Youngermaster/Irrigation-System/InformeFinalElectronica.docx

ELECTRÓNICA DIGITAL

PROYECTO FINAL

ESTUDIANTES:

Camila Barona Cabrera

María Antonia Rincón Zuluaga

Valeria Suárez Mejía

María Sofía Uribe Cano

Juan Manuel Young Hoyos

FECHA:

28 DE MAYO DE 2019

UNIVERSIDAD EAFIT

MEDELLÍN

2019

TABLA DE CONTENIDO

1. Descripción de la Aplicación IoT 2

2. Arquitectura del Sistema 2

3. Cálculos Electrónicos 2

4. Planos del Sistema 1

5. Código de Arduino 2

6. Presentación del Proyecto (Video) 2

7. Conclusiones 2

# 1. Descripción de la Aplicación IoT

Ubidots nos permite almacenar datos de sensores en la nube, además de que los podemos visualizar en tiempo real en la interfaz que nos ofrece Ubidots o en una página web.

En la imagen se puede ver como se almacenan todos los datos de los sensores que tenemos registrados.

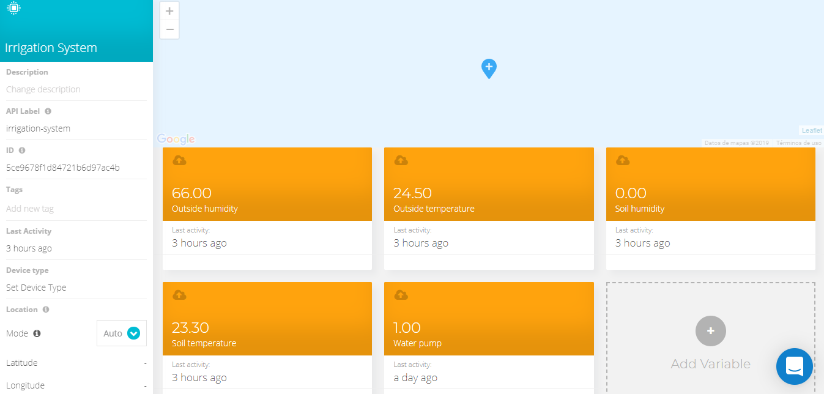
[picture p3: figure]

Podemos ver la gráfica de la actividad de cada variable.

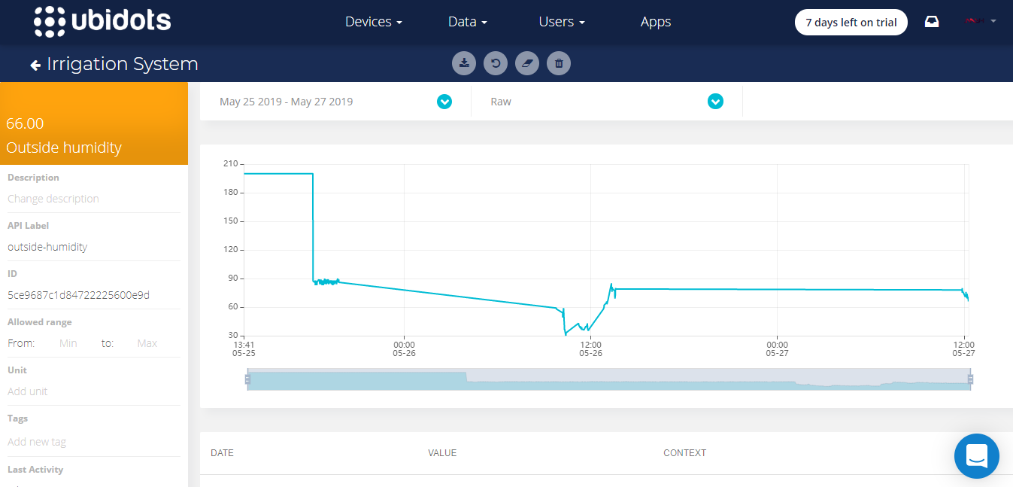
[picture p4: figure]

Y también vemos el reporte no gráfico del cambio de la variable con sus fechas y horas correspondientes.

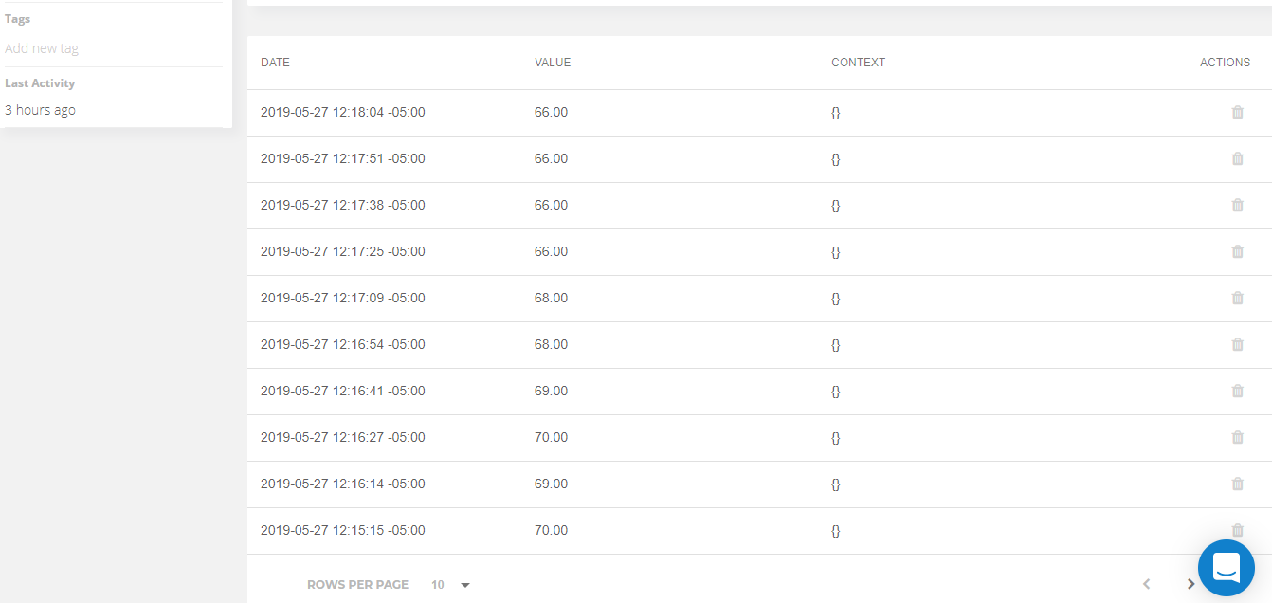
[picture p5: figure]

El usuario puede activar el riego de la planta manualmente, utilizando el botón que se encuentra en la página web, permitiendo así una interacción directa con el sistema.

El botón está relacionado con una variable booleana de Ubidots, que cambia el estado (encendido o apagado) de la variable que corresponde a la bomba de agua.

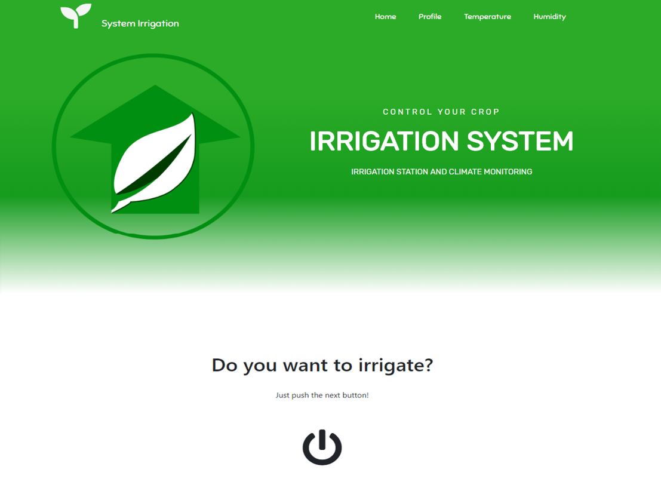
[picture p6: figure]

También en la página web se pueden ver los datos de las variables, que van a estar actualizándose constantemente.

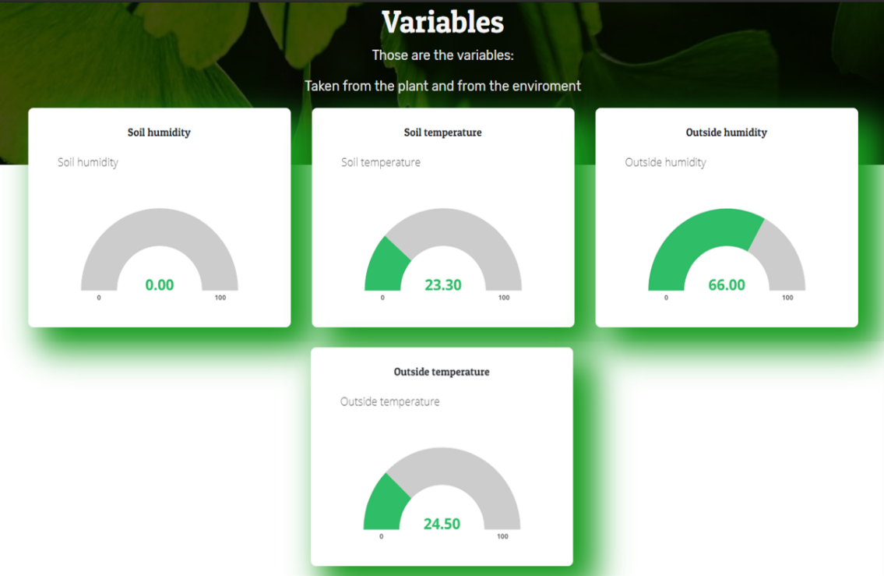
[picture p7: figure]

# 2. Arquitectura del Sistema

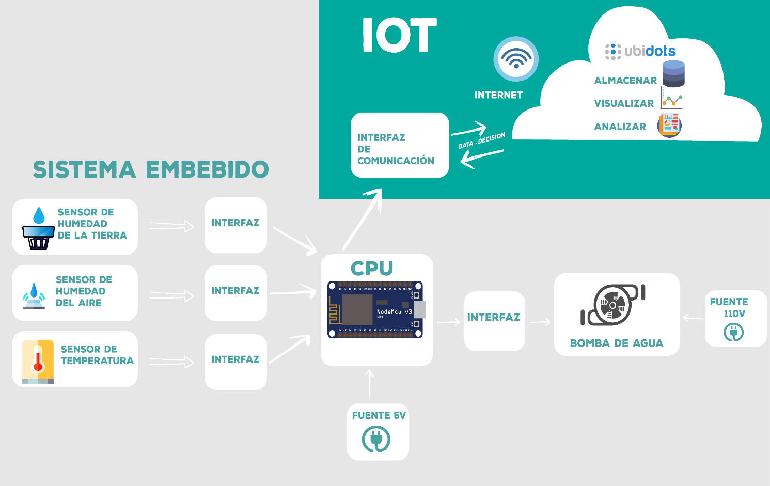
[picture p8: figure]

Ilustración 1: Arquitectura que compone el sistema

# 3. Cálculos Electrónicos

Diseño de transistores como suiches

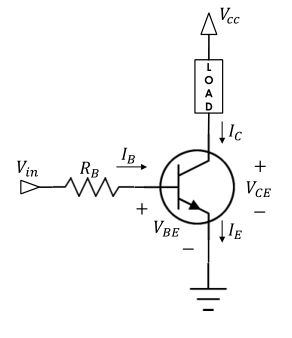
[picture p9: figure]
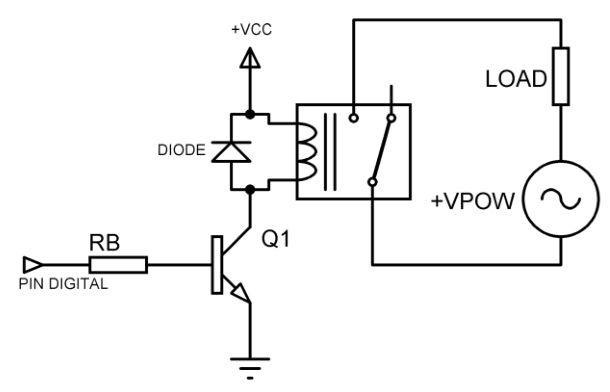
[picture p10: figure]

La fórmula para calcular R_B es:

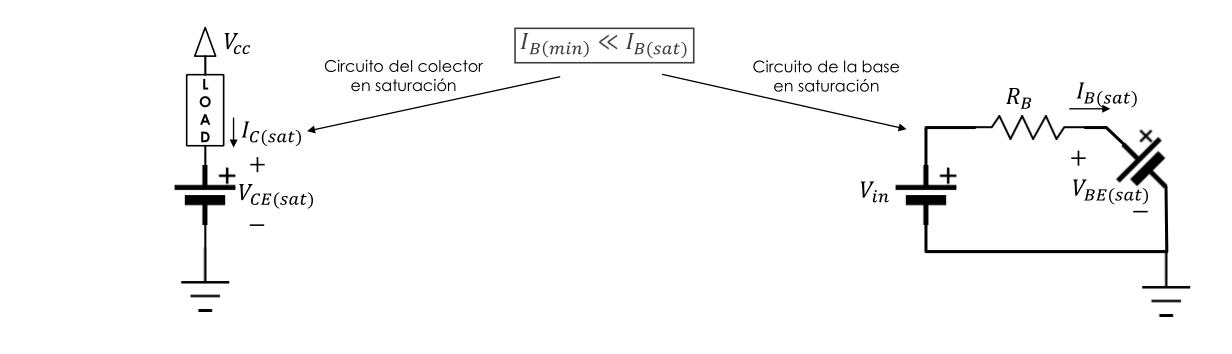
[picture p11: figure]

Suponiendo LOAD como una carga resistiva:

LOAD=R_(LOAD)

V_(LOAD) =V_(CC) -V_(CE(sat))

Por ley de ohm y sabiendo que

I_(C(sat)) =(V_(LOAD))/(R_(LOAD))

Por el β del transistor podemos calcular la corriente de base mínima:

I_(B(min)) =(I_(C(sat)))/β

I_(B(min)) =(V_(CC) -V_(CE(sat)))/(R_(LOAD) ∙β)

V_(R_B) =V_(in) -V_(BE(sat))

Por ley de ohm:

I_(B(sat)) =(V_(R_B))/(R_B)

I_(B(sat)) =(V_(in) -V_(BE(sat)))/(R_B)

Ahora procedemos a reemplazar en la primera ecuación

(V_(CC) -V_(CE(sat)))/(R_(LOAD) ∙β)≪(V_(in) -V_(BE(sat)))/(R_B)

Despejamos R_B :

R_B ≪(R_(LOAD) ∙β(V_(in) -V_(BE(sat)) ))/(V_(CC) -V_(CE(sat))) Ecuación (1)

Los datos para el circuito que se quiere calcular son

R_B ≪(R_(LOAD) ∙β(V_(in) -V_(BE(sat)) ))/(V_(CC) -V_(CE(sat)))

En este casó R_(LOAD) =R_(RELE) =101.8Ω

V_(CC) =5V (Voltaje fuente para alimentar el relé)

V_(in) =5V (Voltaje suministrado por el arduino)

V_(BE(sat)) =0.8V

V_(CE(sat)) =0.2V

β=100(transistor estándar pn2222A)

Reemplazando en la ecuación (1)

R_B ≪(R_(LOAD) ∙β(V_(in) -V_(BE(sat)) ))/(V_(CC) -V_(CE(sat)))

R_B ≪((110Ω )(100)(5V-0.8V))/(5V-0.2V)

R_B ≪9625 Ω

El ARDUINO solo puede manejar por pin una corriente de 40 nA como máximo, Calculemos cual es la resistencia mínima que podríamos usar con el nodemcu:

I_(pinArd) =I_(B(sat)) <12 mA

(V_(in) -V_(BE(sat)))/(R_B)<0.012 A

(5V-0.8V)/(R_B)<0.012 A

Despejando R_B ,

R_B >(5V-0.8V)/(0.012 A)

R_B >105Ω

Así, 350Ω<R_B ≪9625 Ω

El módulo de relevos escogido utiliza R_B =510Ω

# 4. Planos del Sistema

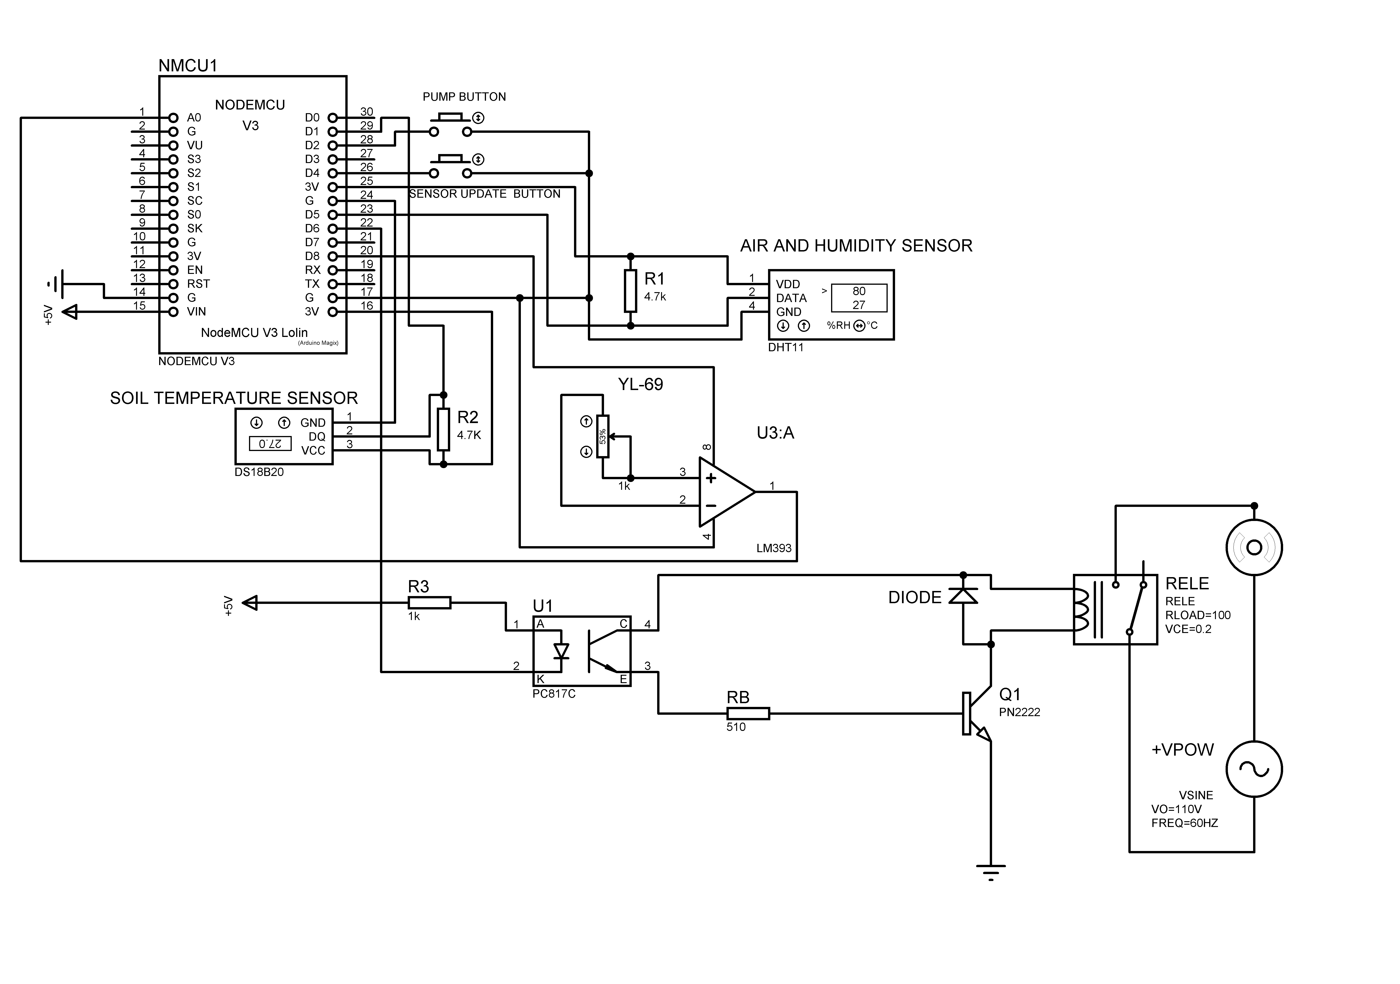
[picture p12: figure]

Ilustración 2: Planos en Proteus

# 5. Código de Arduino

El Código de Arduino correctamente organizado y comentado se puede encontrar en

https://github.com/msuribec/Elect/tree/master

# 6. Presentación del Proyecto (Video)

(Link al video de funcionamiento completo (subido a YouTube), mostrando todo el equipo de trabajo, presentandose cada uno y que expliquen claramente o paso por paso como funciona.)

# 7. Conclusiones

Este proyecto, al tomar la información y permitir actuar sobre la misma, facilita y optimiza el proceso de cuidar planta por planta, lo cual consume tiempo y es ineficiente. Con esto, se sabe que se facilitará la labor de cualquier persona al cuidar de sus plantas o cultivos.

Al tomar los datos de cada variable con una periodicidad constante, se nos permite tener datos precisos acerca del estado de la planta, lo cual facilita saber la cantidad necesaria de agua que se le debe suministrar a la misma.

El tomar los datos y enviarlos a una plataforma y/o aplicación, permitirá que el usuario tenga mejor control sobre su planta en cualquier lugar, además de que podrá cuidarla y actuar sobre ella en tiempo real, facilitando así esta labor.

Si se tienen en cuenta el cuidado de cada planta en particular, el sistema se puede adaptar a la misma, es decir, dependiendo de las necesidades de la planta, se le podrá suministrar agua a la misma en cantidades particulares para ella.
