Youngermaster/Irrigation-System/Web page/assets/images/Wallpapers/903837-download-background-hd-1920x1080-green-1920x1080-for-android-40.jpg

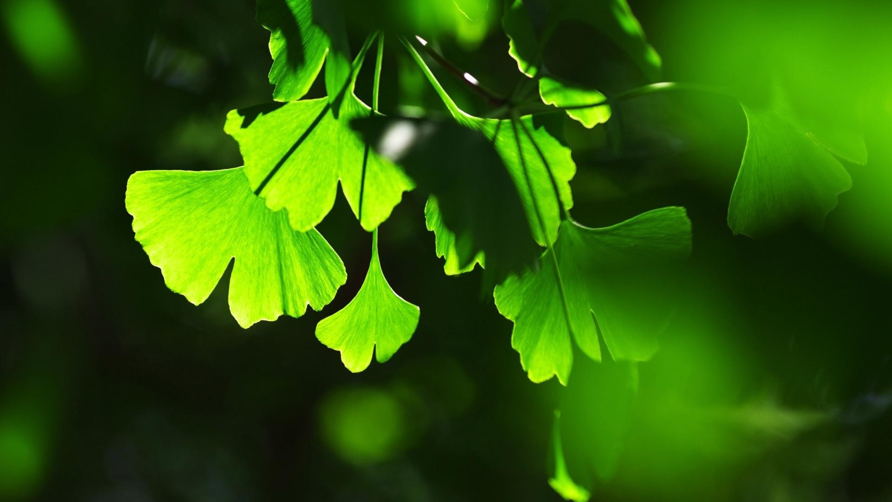
Web page/assets/images/Wallpapers/903837-download-background-hd-1920x1080-green-1920x1080-for-android-40.jpg
