Youngermaster/Irrigation-System/(commit log)

2019-05-04 Sofia added some code to read the temperature
2019-05-20 I changed the path of the web page and the Arduino code
2020-10-16 📜 Readme.md Updated and some code formatted
2020-10-16 📜 README.md Updated
2020-10-18 👍 project finished
